cese-dci/tp-dci--Gonzalogontad/info/Foto EasyDriver back.jpeg

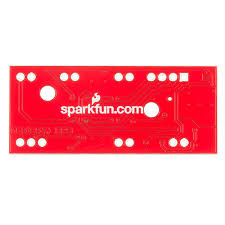
info/Foto EasyDriver back.jpeg
