cese-dci/tp-dci--Gonzalogontad/DOC/README.md

## Replica Dual EasyDriver v4.5

Este proyecto se realiza como trabajo final de la materia Diseño de Circuitos Impresos de la CESE-FIUBA.
Tiene como objetivo el diseño de un circuito impreso y el esquemático en Kicad.

El circuito se basa en una réplica del módulo EasyDriver v4.5 para motores paso a paso al cual se le hace una modificación para transformarlo en un driver doble (puede controlar dos motores PaP) pero con solo una etapa de alimentación. 
Los drivers están basados en el circuito integrado A3967, que incluye tanto la etapa de potencia como la de generación de secuencias para lograr una resolución de hasta 1/8 de paso del motor.

El circuito tiene una entrada de alimentación de hasta 30VDC y el consumo máximo es de 3A.
