cese-dci/tp-dci--Gonzalogontad/PCB/DCI_TP_Final_GG/DCI_TP_Final_GG.kicad_pcb

## KiCad design PCB/DCI_TP_Final_GG/DCI_TP_Final_GG.kicad_pcb (2019-11-19)

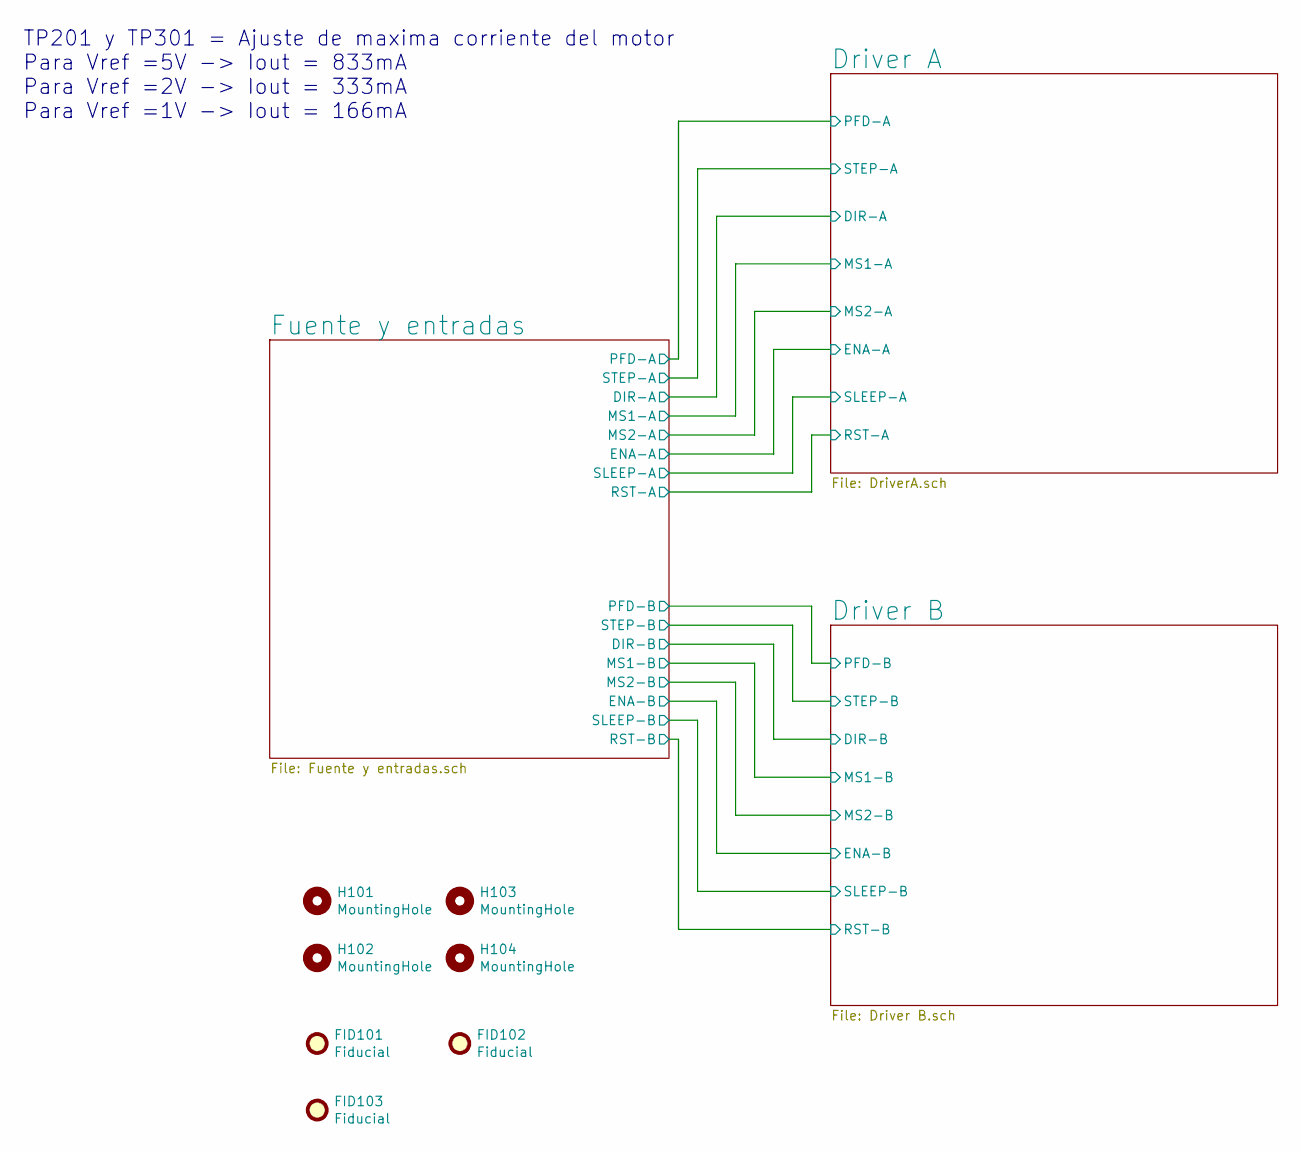
[picture p3: schematic DCI_TP_Final_GG.sch, Replica Dual EasyDriver v4.5]

Parts:
FID101, FID102, FID103: Fiducial; Fiducial_1mm_Mask2mm
H101, H102, H103, H104: MountingHole; MountingHole_3mm

Notes on the sheet:
TP201 y TP301 = Ajuste de maxima corriente del motor Para Vref =5V -> Iout = 833mA Para Vref =2V -> Iout = 333mA Para Vref =1V -> Iout = 166mA

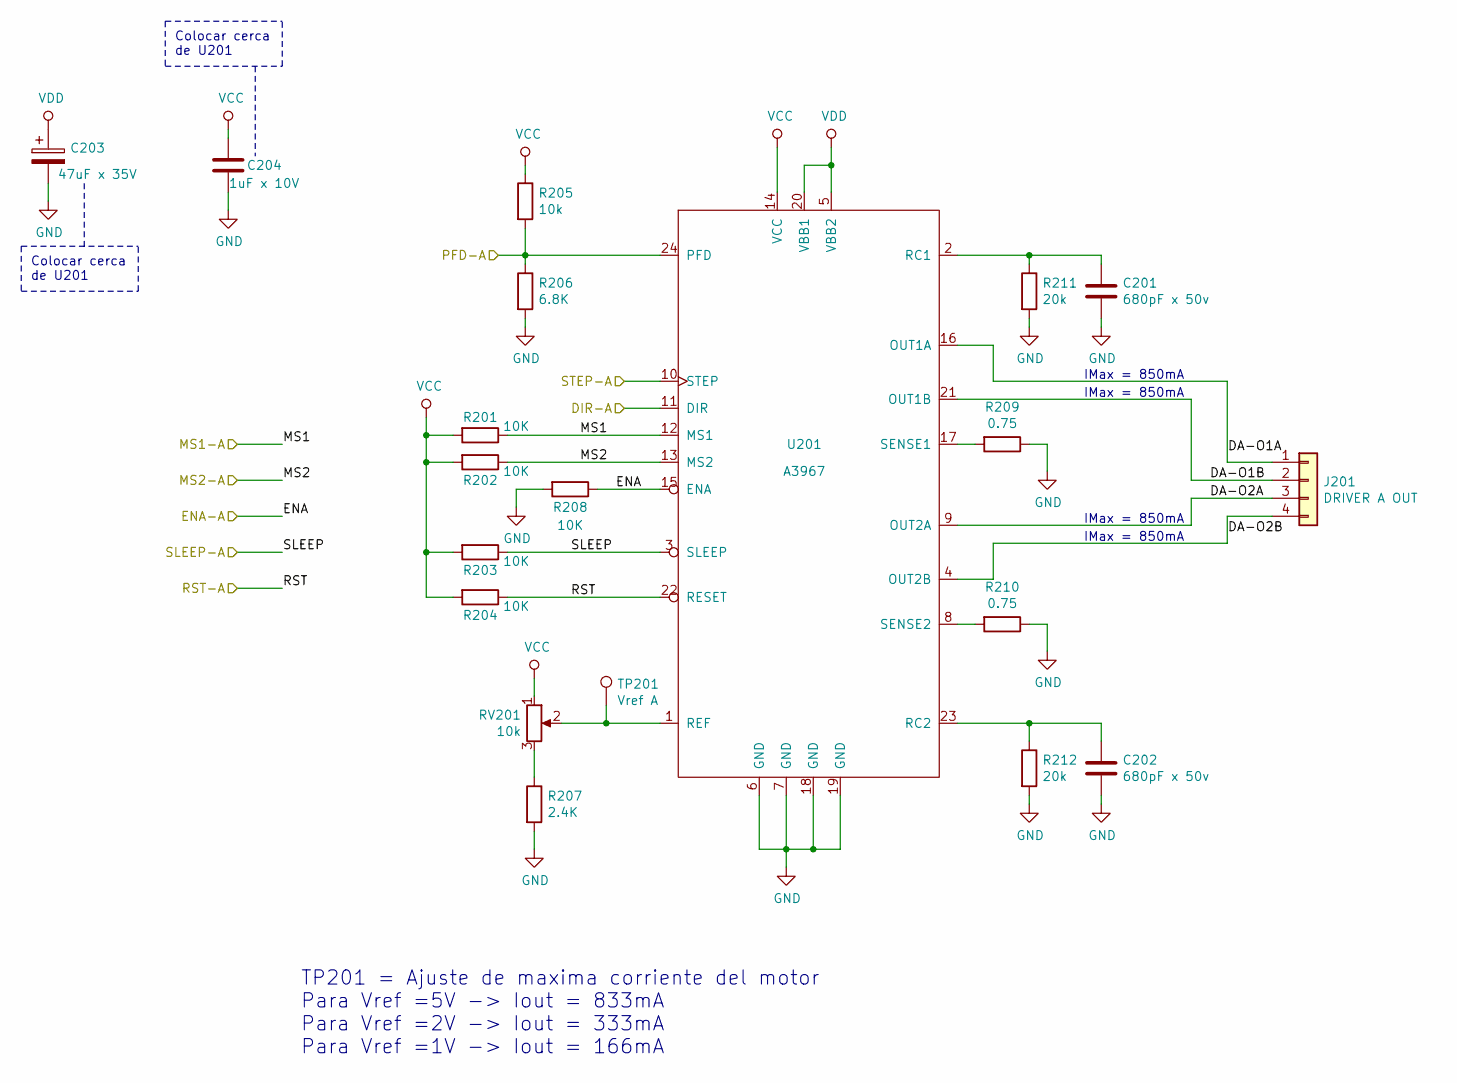
[picture p4: schematic DriverA.sch, Replica Dual EasyDriver v4.5]

Parts:
C201, C202: 680pF x 50v; C_0805_2012Metric; digikey# 399-8110-1-ND
C203: 47uF x 35V; CP_Radial_D5.0mm_P2.00mm; digikey# 493-11044-1-ND
C204: 1uF x 10V; C_0805_2012Metric; digikey# 399-1172-1-ND
J201: DRIVER A OUT; TerminalBlock_Phoenix_MKDS-1,5-4_1x04_P5.00mm_Horizontal; digikey# 277-1238-ND
R201, R202, R203, R204, R208: 10K; R_0805_2012Metric; digikey# 311-10KARCT-ND
R205: 10k; R_0805_2012Metric; digikey# 311-10KARCT-ND
R206: 6.8K; R_0805_2012Metric; digikey# 311-6.80KCRCT-ND
R207: 2.4K; R_0805_2012Metric; digikey# 311-2.40KCRCT-ND
R209, R210: 0.75; R_0805_2012Metric; digikey# RCWE.75DCT-ND
R211, R212: 20k; R_0805_2012Metric; digikey# 311-20.0KCRCT-ND
RV201: 10k; Potentiometer_Vishay_TS53YJ_Vertical; digikey# TS53YJ-10KTR-ND
TP201: Vref A; TestPoint_Pad_D2.0mm
U201: A3967; SOIC-24W_7.5x15.4mm_P1.27mm; digikey# 620-1140-1-ND

Connections:
/Driver A/DA-O1A: J201.1, U201.16 (OUT1A)
/Driver A/DA-O1B: J201.2, U201.21 (OUT1B)
/Driver A/DA-O2A: J201.3, U201.9 (OUT2A)
/Driver A/DA-O2B: J201.4, U201.4 (OUT2B)
/Driver A/DIR-A: U201.11 (DIR); also elsewhere on the board
/Driver A/ENA-A: R208.1, U201.15 (ENA); also elsewhere on the board
/Driver A/MS1-A: R201.1, U201.12 (MS1); also elsewhere on the board
/Driver A/MS2-A: R202.1, U201.13 (MS2); also elsewhere on the board
/Driver A/PFD-A: R205.2, R206.1, U201.24 (PFD); also elsewhere on the board
/Driver A/RST-A: R204.1, U201.22 (RESET); also elsewhere on the board
/Driver A/SLEEP-A: R203.1, U201.3 (SLEEP); also elsewhere on the board
/Driver A/STEP-A: U201.10 (STEP); also elsewhere on the board
GND: C201.2, C202.2, C203.2, C204.2, R206.2, R207.2, R208.2, R209.1, R210.1, R211.2, R212.2, U201.6 (GND), U201.7 (GND), U201.18 (GND), U201.19 (GND); also elsewhere on the board
unnamed: C201.1, R211.1, U201.2 (RC1)
unnamed: C202.1, R212.1, U201.23 (RC2)
unnamed: R207.1, RV201.3
unnamed: R209.2, U201.17 (SENSE1)
unnamed: R210.2, U201.8 (SENSE2)
unnamed: RV201.2, TP201.1, U201.1 (REF)
VCC: C204.1, R201.2, R202.2, R203.2, R204.2, R205.1, RV201.1, U201.14 (VCC); also elsewhere on the board
VDD: C203.1, U201.5 (VBB2), U201.20 (VBB1); also elsewhere on the board

Notes on the sheet:
IMax = 850mA
TP201 = Ajuste de maxima corriente del motor Para Vref =5V -> Iout = 833mA Para Vref =2V -> Iout = 333mA Para Vref =1V -> Iout = 166mA
Colocar cerca de U201

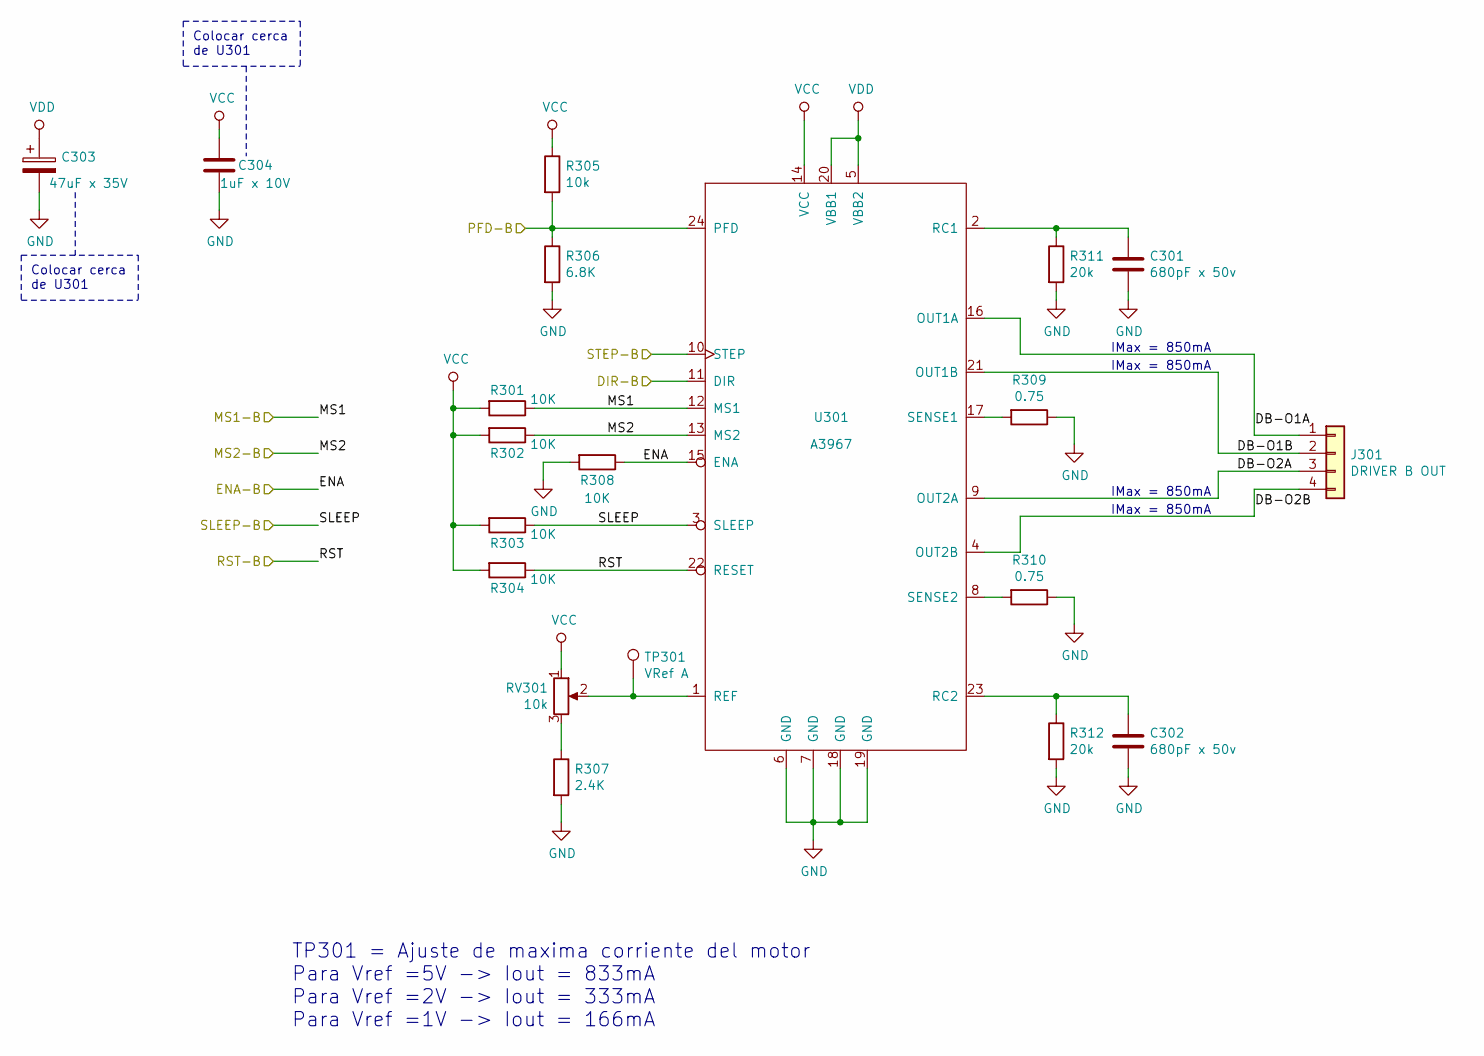
[picture p5: schematic Driver B.sch, Replica Dual EasyDriver v4.5]

Parts:
C301, C302: 680pF x 50v; C_0805_2012Metric; digikey# 399-8110-1-ND
C303: 47uF x 35V; CP_Radial_D5.0mm_P2.00mm; digikey# 493-11044-1-ND
C304: 1uF x 10V; C_0805_2012Metric; digikey# 399-1172-1-ND
J301: DRIVER B OUT; TerminalBlock_Phoenix_MKDS-1,5-4_1x04_P5.00mm_Horizontal; digikey# 277-1238-ND
R301, R302, R303, R304, R308: 10K; R_0805_2012Metric; digikey# 311-10KARCT-ND
R305: 10k; R_0805_2012Metric; digikey# 311-10KARCT-ND
R306: 6.8K; R_0805_2012Metric; digikey# 311-6.80KCRCT-ND
R307: 2.4K; R_0805_2012Metric; digikey# 311-2.40KCRCT-ND
R309, R310: 0.75; R_0805_2012Metric; digikey# RCWE.75DCT-ND
R311, R312: 20k; R_0805_2012Metric; digikey# 311-20.0KCRCT-ND
RV301: 10k; Potentiometer_Vishay_TS53YJ_Vertical; digikey# TS53YJ-10KTR-ND
TP301: VRef A; TestPoint_Pad_D2.0mm
U301: A3967; SOIC-24W_7.5x15.4mm_P1.27mm; digikey# 620-1140-1-ND

Connections:
/Driver B/DB-O1A: J301.1, U301.16 (OUT1A)
/Driver B/DB-O1B: J301.2, U301.21 (OUT1B)
/Driver B/DB-O2A: J301.3, U301.9 (OUT2A)
/Driver B/DB-O2B: J301.4, U301.4 (OUT2B)
/Driver B/DIR-B: U301.11 (DIR); also elsewhere on the board
/Driver B/ENA-B: R308.1, U301.15 (ENA); also elsewhere on the board
/Driver B/MS1-B: R301.1, U301.12 (MS1); also elsewhere on the board
/Driver B/MS2-B: R302.1, U301.13 (MS2); also elsewhere on the board
/Driver B/PFD-B: R305.2, R306.1, U301.24 (PFD); also elsewhere on the board
/Driver B/RST-B: R304.1, U301.22 (RESET); also elsewhere on the board
/Driver B/SLEEP-B: R303.1, U301.3 (SLEEP); also elsewhere on the board
/Driver B/STEP-B: U301.10 (STEP); also elsewhere on the board
GND: C301.2, C302.2, C303.2, C304.2, R306.2, R307.2, R308.2, R309.1, R310.1, R311.2, R312.2, U301.6 (GND), U301.7 (GND), U301.18 (GND), U301.19 (GND); also elsewhere on the board
unnamed: C301.1, R311.1, U301.2 (RC1)
unnamed: C302.1, R312.1, U301.23 (RC2)
unnamed: R307.1, RV301.3
unnamed: R309.2, U301.17 (SENSE1)
unnamed: R310.2, U301.8 (SENSE2)
unnamed: RV301.2, TP301.1, U301.1 (REF)
VCC: C304.1, R301.2, R302.2, R303.2, R304.2, R305.1, RV301.1, U301.14 (VCC); also elsewhere on the board
VDD: C303.1, U301.5 (VBB2), U301.20 (VBB1); also elsewhere on the board

Notes on the sheet:
IMax = 850mA
TP301 = Ajuste de maxima corriente del motor Para Vref =5V -> Iout = 833mA Para Vref =2V -> Iout = 333mA Para Vref =1V -> Iout = 166mA
Colocar cerca de U301

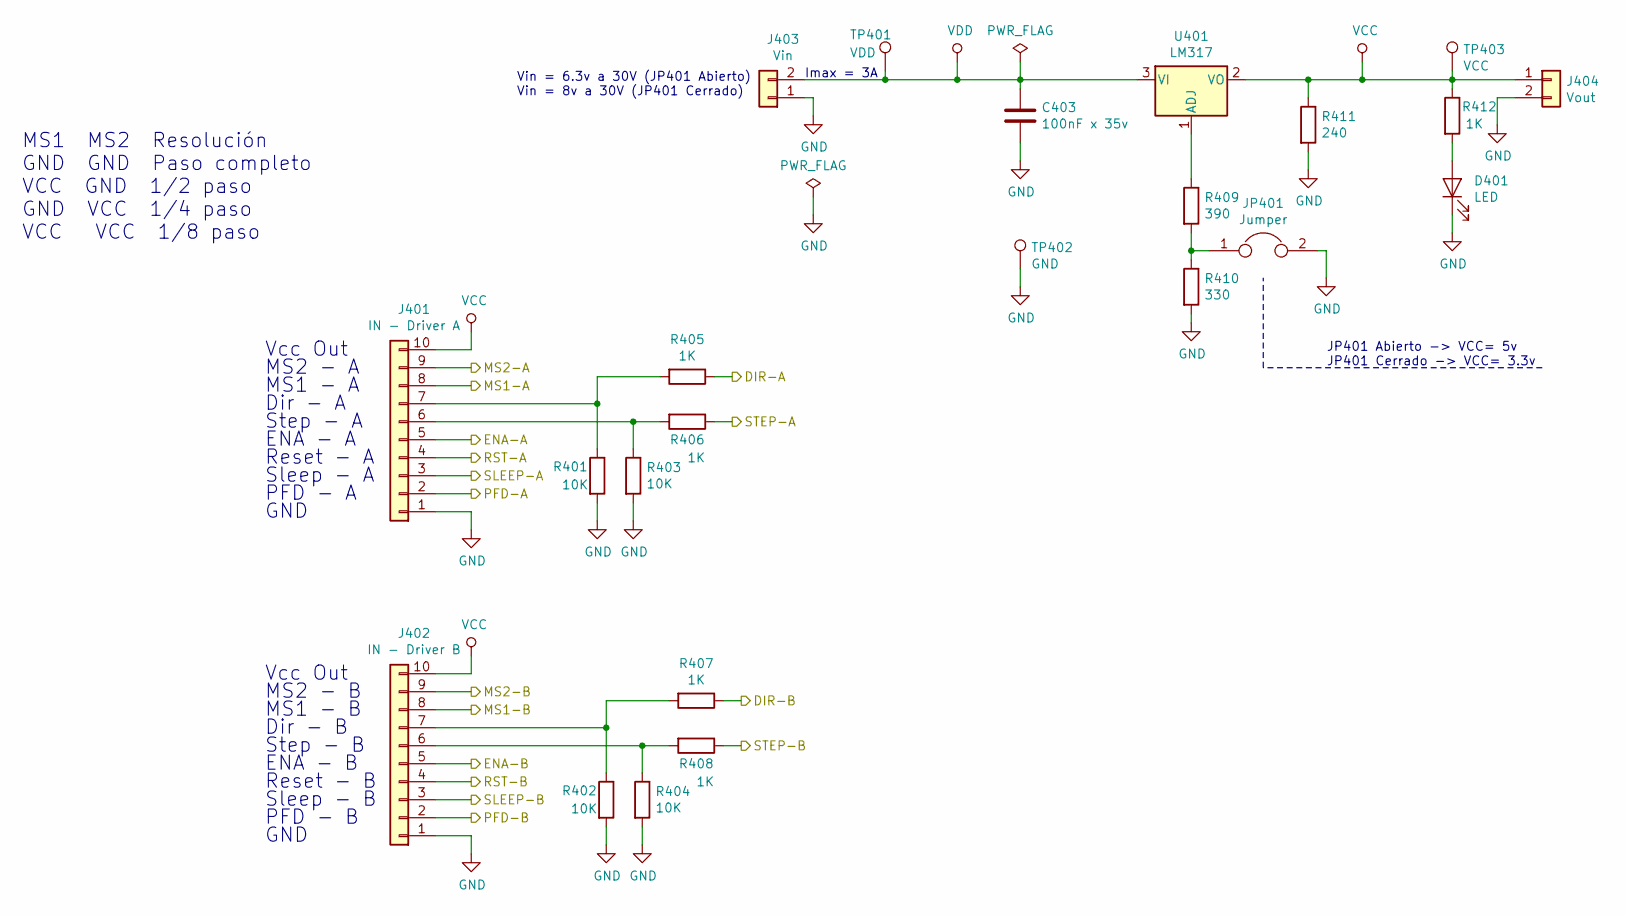
[picture p6: schematic Fuente y entradas.sch, Replica Dual EasyDriver v4.5]

Parts:
C403: 100nF x 35v; C_0805_2012Metric; digikey# 587-3364-1-ND
D401: LED; LED_D3.0mm; digikey# 1516-1350-ND
J401: IN - Driver A; PinHeader_1x10_P2.54mm_Vertical; digikey# WM20125-ND
J402: IN - Driver B; PinHeader_1x10_P2.54mm_Vertical; digikey# WM20125-ND
J403: Vin; TerminalBlock_Phoenix_MKDS-1,5-2_1x02_P5.00mm_Horizontal; digikey# 277-1258-ND
J404: Vout; PinHeader_1x02_P2.54mm_Vertical; digikey# 952-2262-ND
JP401: Jumper; R_0805_2012Metric; digikey# CR0805-J/-000ELFCT-ND
R401, R402, R403, R404: 10K; R_0805_2012Metric; digikey# 311-10KARCT-ND
R405, R406, R407, R408, R412: 1K; R_0805_2012Metric; digikey# 311-1.00CRCT-ND
R409: 390; R_0805_2012Metric; digikey# 311-390CRCT-ND
R410: 330; R_0805_2012Metric; digikey# 311-330CRCT-ND
R411: 240; R_0805_2012Metric; digikey# 311-.24SCT-ND
TP401: VDD; TestPoint_Pad_D2.0mm
TP402: GND; TestPoint_Pad_D2.0mm
TP403: VCC; TestPoint_Pad_D2.0mm
U401: LM317; SOT-223-3_TabPin2; digikey# LM317MSTT3GOSCT-ND

Connections:
/Driver A/DIR-A: R405.1; also elsewhere on the board
/Driver A/ENA-A: J401.5; also elsewhere on the board
/Driver A/MS1-A: J401.8; also elsewhere on the board
/Driver A/MS2-A: J401.9; also elsewhere on the board
/Driver A/PFD-A: J401.2; also elsewhere on the board
/Driver A/RST-A: J401.4; also elsewhere on the board
/Driver A/SLEEP-A: J401.3; also elsewhere on the board
/Driver A/STEP-A: R406.1; also elsewhere on the board
/Driver B/DIR-B: R407.1; also elsewhere on the board
/Driver B/ENA-B: J402.5; also elsewhere on the board
/Driver B/MS1-B: J402.8; also elsewhere on the board
/Driver B/MS2-B: J402.9; also elsewhere on the board
/Driver B/PFD-B: J402.2; also elsewhere on the board
/Driver B/RST-B: J402.4; also elsewhere on the board
/Driver B/SLEEP-B: J402.3; also elsewhere on the board
/Driver B/STEP-B: R408.1; also elsewhere on the board
GND: C403.2, D401.1 (K), J401.1, J402.1, J403.1, J404.2, JP401.2, R401.2, R402.2, R403.2, R404.2, R410.2, R411.2, TP402.1; also elsewhere on the board
unnamed: D401.2 (A), R412.2
unnamed: J401.6, R403.1, R406.2
unnamed: J401.7, R401.1, R405.2
unnamed: J402.6, R404.1, R408.2
unnamed: J402.7, R402.1, R407.2
unnamed: JP401.1, R409.2, R410.1
unnamed: R409.1, U401.1 (ADJ)
VCC: J401.10, J402.10, J404.1, R411.1, R412.1, TP403.1, U401.2 (VO); also elsewhere on the board
VDD: C403.1, J403.2, TP401.1, U401.3 (VI); also elsewhere on the board

Notes on the sheet:
Vin = 6.3v a 30V (JP401 Abierto) Vin = 8v a 30V (JP401 Cerrado)
JP401 Abierto -> VCC= 5v JP401 Cerrado -> VCC= 3.3v
Vcc Out
Step - A
Dir - A
MS1 - A
MS2 - A
ENA - A
Reset - A
Sleep - A
PFD - A
GND
Step - B
Dir - B
MS1 - B
MS2 - B
ENA - B
Reset - B
Sleep - B
PFD - B
MS1 MS2 Resolución GND GND Paso completo VCC GND 1/2 paso GND VCC 1/4 paso VCC VCC 1/8 paso
Imax = 3A

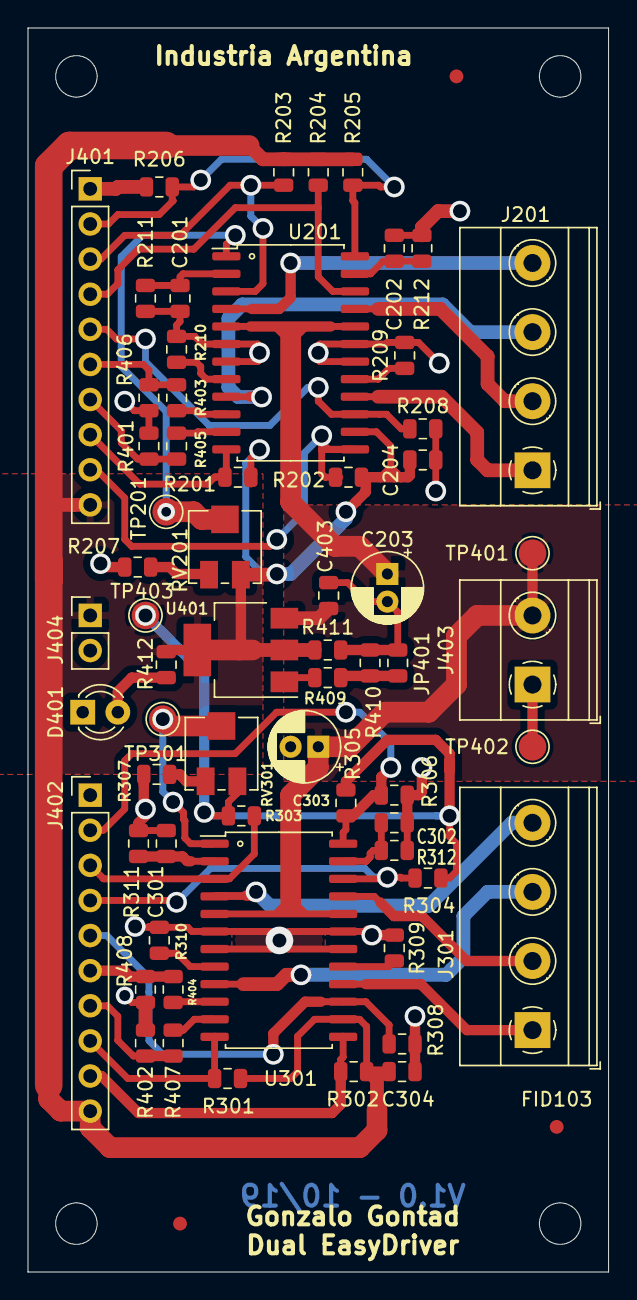
[picture p7: board DCI_TP_Final_GG.kicad_pcb from above]

Board: 2 copper layers, 42.0 x 90.0 mm, 70 parts (0 on the bottom side), 46 nets.
