cese-dci/tp-dci--Gonzalogontad/(commit log)

2019-09-17 Agrego archivos de la propuesta de TP para DCI
2019-09-17 Cambio de nombre a carpeta Documentacion Previa por info
2019-10-02 Creo carpeta PCB y creo el proyecto del PCB en Kicad
    [DCI_TP_Final_GG.kicad_pcb, DCI_TP_Final_GG.sch]
2019-10-04 3/10/2019 Creacion de la jerarquia de archivos para el esquematico Dibujo Driver A y Driver B
    [DCI_TP_Final_GG.sch, Driver B.sch, DriverA.sch, Fuente y entradas.sch]
2019-10-04 Agrego esquematico de fuente (falta completar)
    [DCI_TP_Final_GG.sch, Fuente y entradas.sch]
2019-10-04 Hoja de fuente y conectores completa.
    [DCI_TP_Final_GG.sch, Driver B.sch, DriverA.sch, Fuente y entradas.sch]
2019-10-05 Se completo el esquematico y documentación. El esquematico esta listo para una primera revisión.
    [DCI_TP_Final_GG.sch, Driver B.sch, DriverA.sch, Fuente y entradas.sch]
2019-10-08 Agrego datasheet faltante, foto y biblioteca de componente.
2019-10-10 Inicio etapa de desarrollo de PCB, agrego biblioteca de borneras
    [DCI_TP_Final_GG.sch, Driver B.sch, DriverA.sch, Fuente y entradas.sch]
2019-10-10 Avance en el routeo
    [DCI_TP_Final_GG.kicad_pcb]
2019-10-11 avance en pcb
    [DCI_TP_Final_GG.kicad_pcb]
2019-10-11 Avance en routeo
    [DCI_TP_Final_GG.kicad_pcb, Fuente y entradas.sch]
2019-10-14 avance en ruteo de PCB
    [DCI_TP_Final_GG.kicad_pcb]
2019-10-14 Avance en routeo de PCB
    [DCI_TP_Final_GG.kicad_pcb]
2019-10-17 Agrego 3D de borneras
    [DCI_TP_Final_GG.kicad_pcb, Driver B.sch, DriverA.sch]
2019-10-18 Agrego codigos de catalogo
    [DCI_TP_Final_GG.kicad_pcb, DCI_TP_Final_GG.sch, Driver B.sch, DriverA.sch, Fuente y entradas.sch]
2019-10-18 Version para revision de PCB Exporto modelos 3d y archivos de fabricacion
    [DCI_TP_Final_GG-B_Cu.gbr, DCI_TP_Final_GG-B_Mask.gbr, DCI_TP_Final_GG-B_Paste.gbr, DCI_TP_Final_GG-B_SilkS.gbr, DCI_TP_Final_GG-Edge_Cuts.gbr, DCI_TP_Final_GG-F_Cu.gbr, DCI_TP_Final_GG-F_Mask.gbr, DCI_TP_Final_GG-F_Paste.gbr]
2019-10-26 Cambio de ubicacion de capacitores de desacople en la jerarquia del esquematico y actualizacion de identificadores en PCB
    [DCI_TP_Final_GG-B_Cu.gbr, DCI_TP_Final_GG-B_Mask.gbr, DCI_TP_Final_GG-B_Paste.gbr, DCI_TP_Final_GG-B_SilkS.gbr, DCI_TP_Final_GG-Edge_Cuts.gbr, DCI_TP_Final_GG-F_Cu.gbr, DCI_TP_Final_GG-F_Mask.gbr, DCI_TP_Final_GG-F_Paste.gbr]
2019-11-15 Correccion de Plano de masa
    [DCI_TP_Final_GG.kicad_pcb]
2019-11-19 Cambio Versión en PCB
    [DCI_TP_Final_GG.kicad_pcb]
